7west/Quartz/RESEARCH/NOTES/Power.pdf

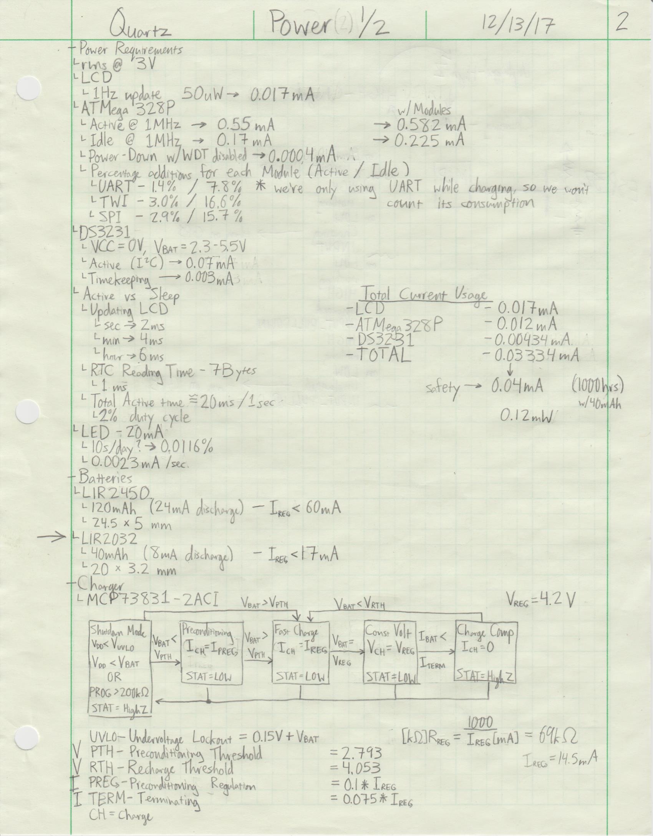
[picture p1: page 1]
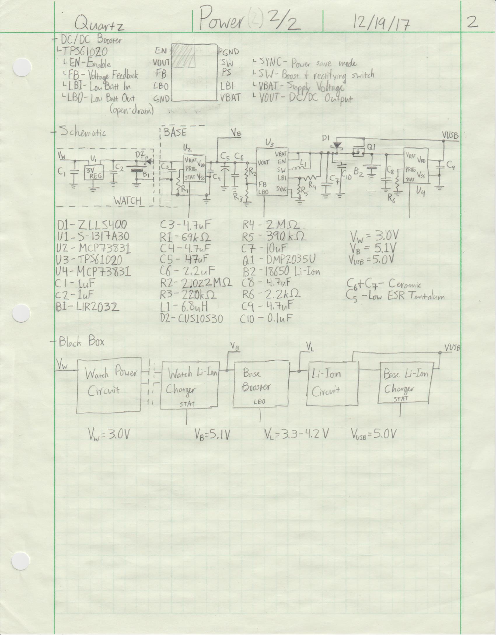
[picture p2: page 2]
