7west/Quartz/EAGLE/power.pdf

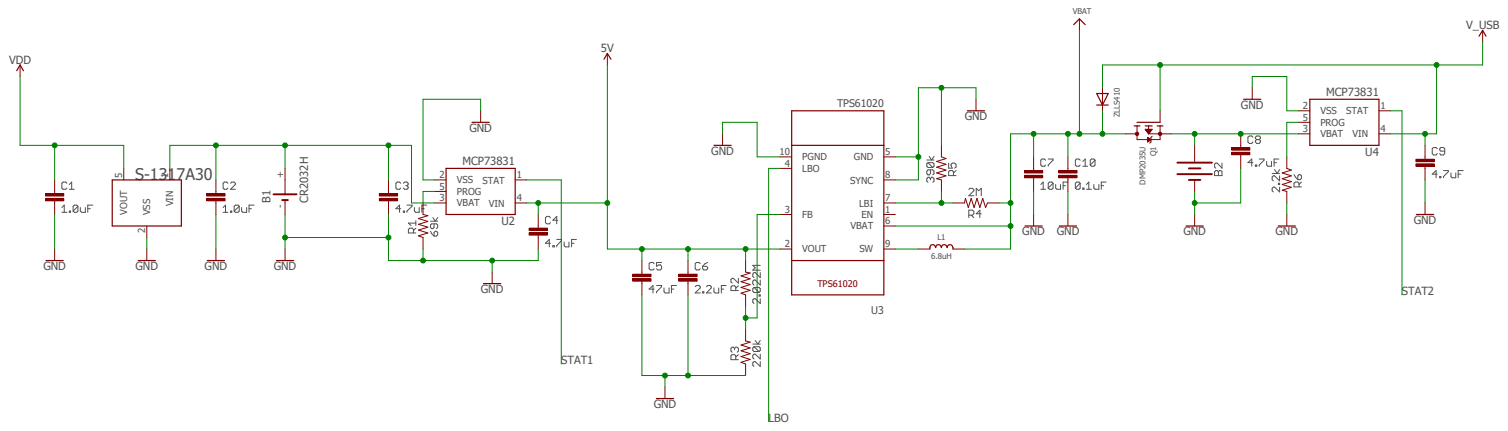
[picture p3: page 1]
MCP73831; MCP73831 TPS61020; GND; VBAT; V_USB; VDD; DMP2035U CR²⁰³²H; GND GND; U2 VIN; 4 STAT; 1 VBAT 3; PROG 5; VSS 2; U4 VIN; VSS 2 EN; LBI; LBO 4; PGND 10; 9 SYNC; 8 VBAT; 6 VOUT 2; U3 VOUT; 5 VIN; 1 VSS; Q¹ ZLLS410 B1 + -; STAT1; LBO; STAT2 TPS61020
