7west/Quartz/EAGLE/power.sch

## EAGLE design EAGLE/power.sch (2018-04-14)

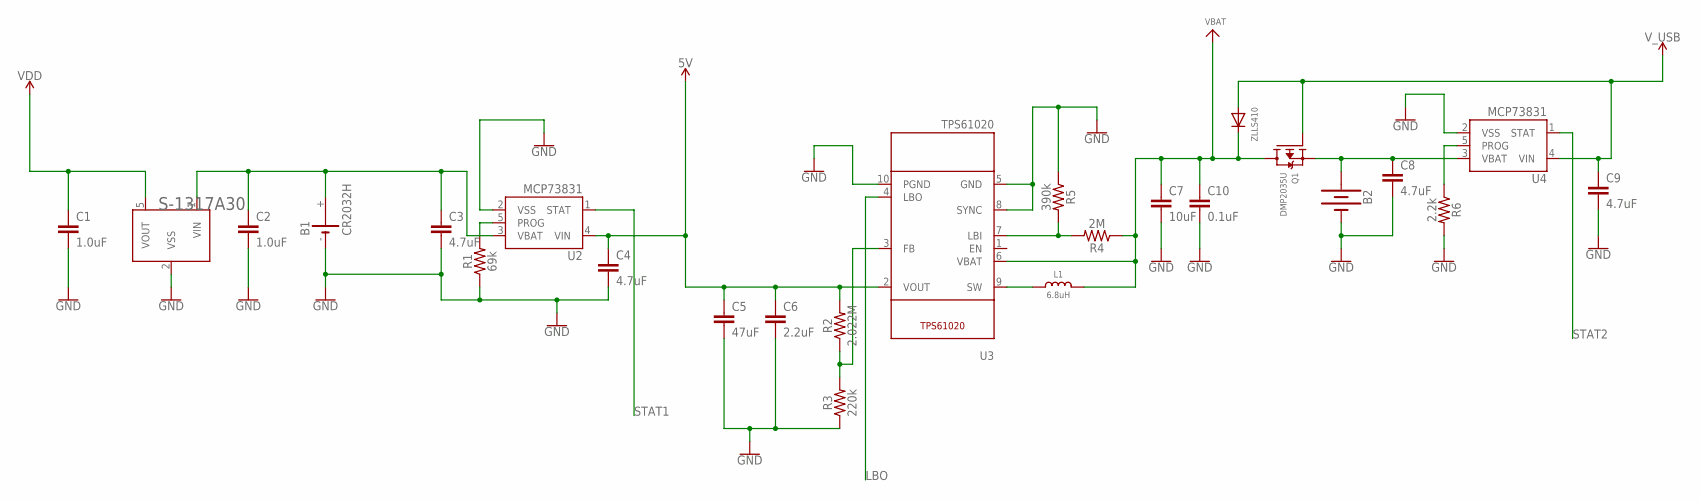
[picture p4: schematic power.sch]

Parts:
B1: CR2032H
B2: BATTERY-18650; BATTERY_18650-HOLDER
C1, C2: 1.0uF; 0805
C3, C4, C8, C9: 4.7uF; 0805
C5: 47uF; 0805
C6: 2.2uF; 0805
C7: 10uF; 0805
C10: 0.1uF; 0805
L1: 6.8uH; INDUCTOR_5X5MM_TDK_VLC5045
Q1: DMP2035U; DMP
R1: 69k; 0805
R2: 2.022M; 0805
R3: 220k; 0805
R4: 2M; 0805
R5: 390k; 0805
R6: 2.2k; 0805
S-1317A30: S1317A30; SOT23-5
U2, U4: MCP73831; SOT23-5
U3: TPS61020; S-PDSO-N10
ZLLS410: DIODESOD-323; SOD-323

Connections:
5V: C4.1, C5.1, C6.1, R2.2, U2.4 (VIN), U3.2 (VOUT)
GND: B1.-, B2.GND@1 (-), C1.2, C2.2, C3.2, C4.2, C5.2, C6.2, C7.2, C8.2, C9.2, C10.2, R1.1, R3.1, R5.1, R6.2, S-1317A30.2 (VSS), U2.2 (VSS), U3.5 (GND), U3.8 (SYNC), U3.10 (PGND), U4.2 (VSS)
LBO: U3.4 (LBO)
unnamed: R4.2, R5.2, U3.7 (LBI)
unnamed: R1.2, U2.5 (PROG)
unnamed: B1.+, C2.1, C3.1, S-1317A30.1 (VIN), U2.3 (VBAT)
unnamed: B2.PWR@1 (+), C8.1, Q1.2 (S), U4.3 (VBAT)
unnamed: R6.1, U4.5 (PROG)
unnamed: R2.1, R3.2, U3.3 (FB)
unnamed: L1.P$1 (1), U3.9 (SW)
STAT1: U2.1 (STAT)
STAT2: U4.1 (STAT)
VBAT: C7.1, C10.1, L1.P$2 (2), Q1.3 (D), R4.1, U3.6 (VBAT), ZLLS410.C
VDD: C1.1, S-1317A30.5 (VOUT)
V_USB: C9.1, Q1.1 (G), U4.4 (VIN), ZLLS410.A
