7west/Quartz/(commit log)

2018-04-14 Power Schematics
    [power.sch]
2018-04-14 Power Notes
2018-05-02 Power Notes Update
